MeldrumJon/Paper-Clock/README.md

# Paper-Clock

Minimalistic clock with an e-ink display.

Photo of the ePaper clock

## Components

- [Enclosure](./3D)
- [PCB](./hardware)
- [Firmware](./src)
