MeldrumJon/Paper-Clock/3D/res/rotaryEncoderPCB.stl

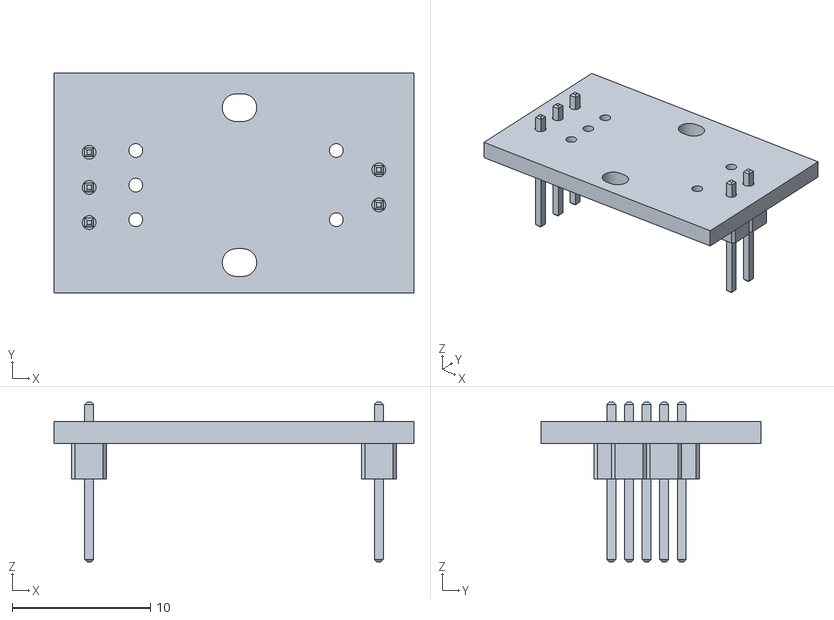
[picture p1: CAD file, 2019-09-21]
3D/res/rotaryEncoderPCB.stl
26.0 x 15.9 x 11.5
