MeldrumJon/Paper-Clock/3D/res/paperClockPCB.stl

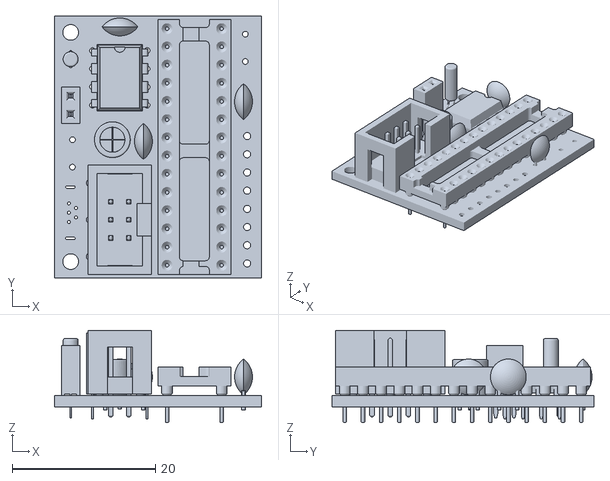
[picture p2: CAD file, 2019-09-15]
3D/res/paperClockPCB.stl
29.0 x 36.6 x 12.9
