MeldrumJon/Paper-Clock/hardware/paperClockPCB.kicad_pcb

## KiCad design hardware/paperClockPCB.kicad_pcb (2019-09-11)

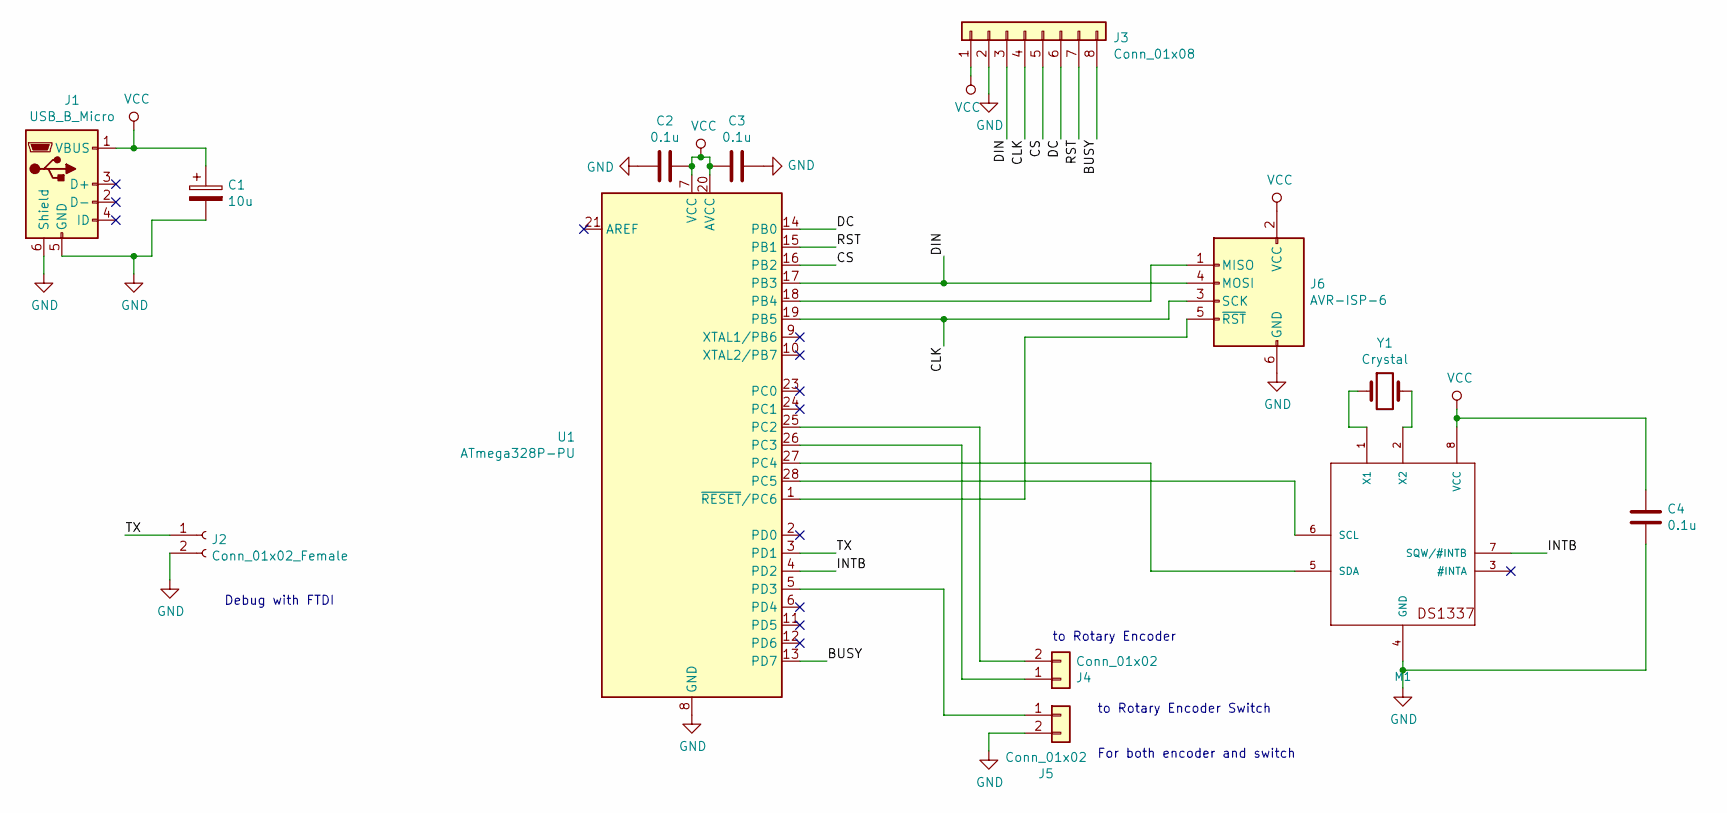
[picture p3: schematic paperClockPCB.sch]

Parts:
C1: 10u; CP_Radial_D5.0mm_P2.00mm
C2, C3, C4: 0.1u; C_Disc_D5.0mm_W2.5mm_P2.50mm
J1: USB_B_Micro; USB_Micro-B_Wuerth_614105150721_Vertical
J2: Conn_01x02_Female; PinSocket_1x02_P2.54mm_Vertical
J3: Conn_01x08; PinSocket_1x08_P2.54mm_Vertical
J4, J5: Conn_01x02; SolderWirePad_1x02_P3.81mm_Drill0.8mm
J6: AVR-ISP-6; IDC-Header_2x03_P2.54mm_Vertical
M1: DS1337; DIP-8_W7.62mm
U1: ATmega328P-PU; DIP-28_W7.62mm_Socket_LongPads
Y1: Crystal; Crystal_C26-LF_D2.1mm_L6.5mm_Vertical

Connections:
/BUSY: J3.8, U1.13 (PD7)
/CLK: J3.4, J6.3 (SCK), U1.19 (PB5)
/CS: J3.5, U1.16 (PB2)
/DC: J3.6, U1.14 (PB0)
/DIN: J3.3, J6.4 (MOSI), U1.17 (PB3)
/INTB: M1.7 (SQW/#INTB), U1.4 (PD2)
/RST: J3.7, U1.15 (PB1)
/TX: J2.1, U1.3 (PD1)
GND: C1.2, C2.2, C3.1, C4.2, J1.5 (GND), J1.6 (Shield), J2.2, J3.2, J5.2, J6.6 (GND), M1.4 (GND), U1.8 (GND), U1.22 (GND)
unnamed: J4.1, U1.26 (PC3)
unnamed: J4.2, U1.25 (PC2)
unnamed: J5.1, U1.5 (PD3)
unnamed: J6.1 (MISO), U1.18 (PB4)
unnamed: J6.5 (~RST), U1.1 (~RESET~/PC6)
unnamed: M1.1 (X1), Y1.1
unnamed: M1.2 (X2), Y1.2
unnamed: M1.5 (SDA), U1.27 (PC4)
unnamed: M1.6 (SCL), U1.28 (PC5)
VCC: C1.1, C2.1, C3.2, C4.1, J1.1 (VBUS), J3.1, J6.2 (VCC), M1.8 (VCC), U1.7 (VCC), U1.20 (AVCC)

Notes on the sheet:
to Rotary Encoder Switch
For both encoder and switch
Debug with FTDI
to Rotary Encoder

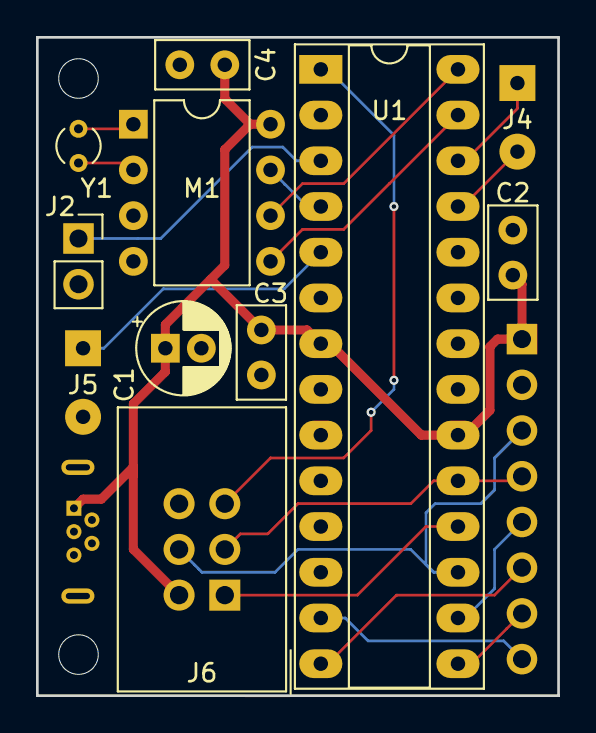
[picture p4: board paperClockPCB.kicad_pcb from above]

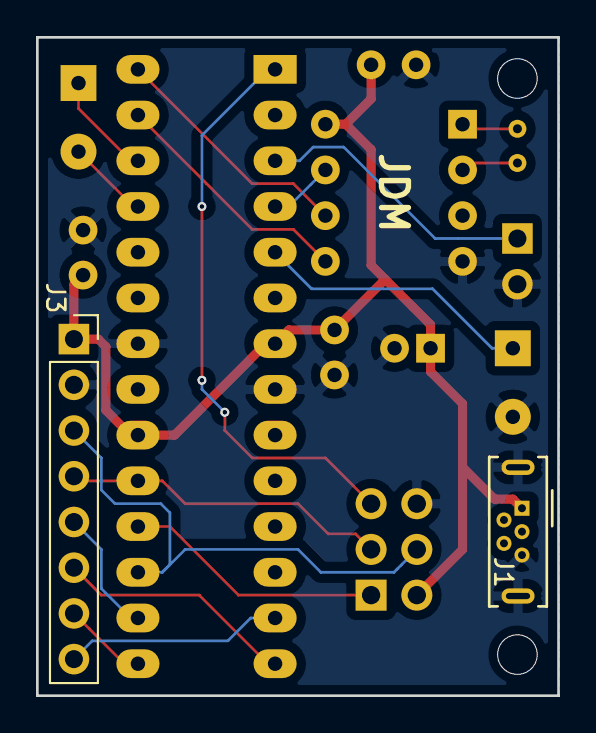
[picture p5: board paperClockPCB.kicad_pcb from below]

Board: 2 copper layers, 29.0 x 36.6 mm, 13 parts (2 on the bottom side), 19 nets.
