MeldrumJon/Paper-Clock/src/src/disp.cpp

#include "disp.h"
#include <avr/pgmspace.h>
#define DISABLE_DIAGNOSTIC_OUTPUT
#define ENABLE_GxEPD2_GFX 0
#include <GxEPD2_BW.h>
#include <U8g2_for_Adafruit_GFX.h>
#include <TimeLib.h>
#include "clock.h"
#include "op.h"

// Fonts
U8G2_FOR_ADAFRUIT_GFX u8g2Fonts;
extern const uint8_t u8g2_font_droidserif_108pt[] U8G2_FONT_SECTION("u8g2_font_droidserif_108pt");
extern const uint8_t u8g2_font_timR18_cc[] U8G2_FONT_SECTION("u8g2_font_timR18_cc");

#define DISP_WIDTH 296
#define DISP_HEIGHT 128

#define SMALL_FONT u8g2_font_timR18_cc
#define BIG_FONT u8g2_font_droidserif_108pt

#define SMALL_FONT_ASCENT 17
#define SMALL_FONT_DESCENT 6
#define SMALL_FONT_HEIGHT 23
#define BIG_FONT_ASCENT 77
#define BIG_FONT_DESCENT 26
#define BIG_FONT_HEIGHT 103

// Fonts
#define TIME_MAX_WIDTH 270

// Main Display

#define DISP_PADDING_TOP 8
#define DISP_PADDING_BOT 12

#define DATE_CURSOR_Y (DISP_PADDING_TOP+SMALL_FONT_ASCENT)
#define TIME_CURSOR_Y (DISP_HEIGHT-DISP_PADDING_BOT)

#define TIME_AREA_PADDING 4

#define TIME_AREA_X ((DISP_WIDTH-TIME_MAX_WIDTH)/2-TIME_AREA_PADDING)
#define TIME_AREA_WIDTH (TIME_MAX_WIDTH+2*TIME_AREA_PADDING)
#define TIME_AREA_Y (DATE_CURSOR_Y+SMALL_FONT_DESCENT+2)
#define TIME_AREA_HEIGHT (DISP_HEIGHT-TIME_AREA_Y)

#define PM_INDICATOR_WIDTH 14
#define PM_INDICATOR_HEIGHT 14
#define PM_INDICATOR_X (DISP_WIDTH-PM_INDICATOR_WIDTH)
#define PM_INDICATOR_Y (DISP_HEIGHT-PM_INDICATOR_HEIGHT)

// Settings
#define SMALL_DATE_WIDTH 45
#define SMALL_TIME_WIDTH 52

#define SET_LINE_SPACING 20

// title
#define SET_TITLE_CURSOR_Y (SET_CURSOR_Y-SET_LINE_SPACING-SMALL_FONT_ASCENT)
#define SET_DATE_TITLE_CURSOR_X ((DISP_WIDTH-SMALL_DATE_WIDTH)/2)
#define SET_TIME_TITLE_CURSOR_X ((DISP_WIDTH-SMALL_TIME_WIDTH)/2)

// "set"
#define SET_SAVE_CURSOR_Y (SET_CURSOR_Y+SET_LINE_SPACING+SMALL_FONT_ASCENT)
#define SET_SAVE_AREA_Y (SET_SAVE_CURSOR_Y-SMALL_FONT_ASCENT-1)
#define SET_SAVE_AREA_HEIGHT (SMALL_FONT_ASCENT+2)

#define SET_SAVE_WIDTH 31
#define SET_SAVING_WIDTH 16
#define SET_SAVE_CURSOR_X ((DISP_WIDTH-SET_SAVE_WIDTH)/2)
#define SET_SAVING_CURSOR_X ((DISP_WIDTH-SET_SAVING_WIDTH)/2)

// actual settings
#define SET_CURSOR_Y ((DISP_HEIGHT+SMALL_FONT_ASCENT)/2)
#define SET_AREA_Y ((DISP_HEIGHT-SMALL_FONT_ASCENT)/2-1)
#define SET_AREA_HEIGHT (SMALL_FONT_ASCENT+2)

// date or time
#define SET_DOT_SPACING 56
#define SET_DOT_WIDTH (SMALL_DATE_WIDTH+SET_DOT_SPACING+SMALL_TIME_WIDTH)

#define SET_DOT_DATE_CURSOR_X ((DISP_WIDTH-SET_DOT_WIDTH)/2)
#define SET_DOT_TIME_CURSOR_X (SET_DOT_DATE_CURSOR_X+SMALL_DATE_WIDTH+SET_DOT_SPACING)

// date
#define SMALL_DASH_WIDTH 6
#define SMALL_YEAR_WIDTH 47
#define SMALL_MONTH_WIDTH 23
#define SMALL_DAY_WIDTH 23

#define SET_DATE_SPACING 16
#define SET_DATE_WIDTH (SMALL_YEAR_WIDTH+SMALL_MONTH_WIDTH+SMALL_DAY_WIDTH+2*SMALL_DASH_WIDTH+4*SET_DATE_SPACING)
#define SET_DATE_CURSOR_X ((DISP_WIDTH-SET_DATE_WIDTH)/2)

#define SET_DATE_YEAR_CURSOR_X (SET_DATE_CURSOR_X)
#define SET_DATE_DASH1_CURSOR_X (SET_DATE_YEAR_CURSOR_X+SMALL_YEAR_WIDTH+SET_DATE_SPACING)
#define SET_DATE_MONTH_CURSOR_X (SET_DATE_DASH1_CURSOR_X+SMALL_DASH_WIDTH+SET_DATE_SPACING)
#define SET_DATE_DASH2_CURSOR_X (SET_DATE_MONTH_CURSOR_X+SMALL_MONTH_WIDTH+SET_DATE_SPACING)
#define SET_DATE_DAY_CURSOR_X (SET_DATE_DASH2_CURSOR_X+SMALL_DASH_WIDTH+SET_DATE_SPACING)

// time
#define SMALL_MERIDIEM_WIDTH 39
#define SMALL_HOUR_WIDTH 23
#define SMALL_COLON_WIDTH 4
#define SMALL_MINUTE_WIDTH 23

#define SET_TIME_MERIDIEM_SPACING 34
#define SET_TIME_COLON_SPACING 12

#define SET_TIME_WIDTH (SMALL_MERIDIEM_WIDTH+SMALL_HOUR_WIDTH+SMALL_MINUTE_WIDTH+SMALL_COLON_WIDTH+SET_TIME_MERIDIEM_SPACING+2*SET_TIME_COLON_SPACING)
#define SET_TIME_CURSOR_X ((DISP_WIDTH-SET_TIME_WIDTH)/2)

#define SET_TIME_MERIDIEM_CURSOR_X SET_TIME_CURSOR_X
#define SET_TIME_HOUR_CURSOR_X (SET_TIME_MERIDIEM_CURSOR_X+SMALL_MERIDIEM_WIDTH+SET_TIME_MERIDIEM_SPACING)
#define SET_TIME_COLON_CURSOR_X (SET_TIME_HOUR_CURSOR_X+SMALL_HOUR_WIDTH+SET_TIME_COLON_SPACING)
#define SET_TIME_MINUTE_CURSOR_X (SET_TIME_COLON_CURSOR_X+SMALL_COLON_WIDTH+SET_TIME_COLON_SPACING)

// Display
#define MAX_DISPAY_BUFFER_SIZE 800 
#define MAX_HEIGHT(EPD) (EPD::HEIGHT <= MAX_DISPAY_BUFFER_SIZE / (EPD::WIDTH / 8) ? EPD::HEIGHT : MAX_DISPAY_BUFFER_SIZE / (EPD::WIDTH / 8))
GxEPD2_BW<GxEPD2_290, MAX_HEIGHT(GxEPD2_290)> display(GxEPD2_290(/*CS=10*/ SS, /*DC=*/ 8, /*RST=*/ 9, /*BUSY=*/ 7));


// Strings
static const char MIL_STR[] = " 24";
static const char AM_STR[] = "AM";
static const char PM_STR[] = "PM";
static const char* const MERIDIEM_STR[3] = {
    MIL_STR,
    AM_STR,
    PM_STR
};
static const char DATE_STR[] = "Date";
static const char TIME_STR[] = "Time";
static const char SAVE_STR[] = "Set";
static const char SAVING_STR[] = "...";

// Variables

// Date/Time Buffers
static char buf18[24]; // Longest date string: "Wednesday, Sep 20, 2019" = 23 chars + \0
static char buf6[6]; // Longest time "12:00" = 5 chars + \0
static char buf3[3]; // Additional settings (days, months, hours, minutes)

static enum updateMode_t {
    FULL,
    TIME
} updateMode;

void disp_init() {
    display.init();
    display.setRotation(1);
    u8g2Fonts.begin(display);
    return;
}

void disp_clear() {
    display.setFullWindow();
    display.firstPage();
    do {
        display.fillScreen(GxEPD_WHITE);
    } while(display.nextPage());
    return;
}

void disp_update(uint8_t refresh /*=0*/) {
    static uint16_t last_year = 0;
    static uint8_t last_month = 0;
    static uint8_t last_day = 0;
    static uint8_t last_hour = 0;
    static uint8_t last_minute = 0;
    static op_meridiem_t last_meridiem = MIL;

    static uint16_t date_x;
    static uint16_t time_x;

    uint8_t date_diff = (op_day != last_day || op_month != last_month || op_year != last_year);
    uint8_t time_diff = (op_minute != last_minute || op_hour != last_hour || op_meridiem != last_meridiem);

    if (!time_diff && !date_diff && !refresh) { // No change, don't do anything
        return;
    }

    if (date_diff || refresh) {
        // Update Date
        sprintf(buf18, "%s, %s %d, %d", 
                dayStr(clock_dayofweek(op_year, op_month, op_day)),
                monthShortStr(op_month), op_day, op_year);
        u8g2Fonts.setFont(SMALL_FONT);
        date_x = (DISP_WIDTH-u8g2Fonts.getUTF8Width(buf18))/2;
    }

    // Update Time
    if (op_meridiem != MIL) {
        sprintf(buf6, "%d:%02d", op_hour, op_minute);
    }
    else {
        sprintf(buf6, "%02d:%02d", op_hour, op_minute);
    }
    u8g2Fonts.setFont(BIG_FONT);
    time_x = (DISP_WIDTH-u8g2Fonts.getUTF8Width(buf6))/2; // Center
    if (op_hour >= 10 && op_hour < 20) { time_x -= 3; }

    u8g2Fonts.setForegroundColor(GxEPD_BLACK);
    u8g2Fonts.setBackgroundColor(GxEPD_WHITE);
    if ((op_minute % 30) == 0 || date_diff || refresh) {
        display.setFullWindow();
        display.firstPage();
        do {
            display.fillScreen(GxEPD_WHITE);
            if (op_meridiem == PM) { 
                display.writeFillRect(PM_INDICATOR_X, PM_INDICATOR_Y, PM_INDICATOR_WIDTH, PM_INDICATOR_HEIGHT, GxEPD_BLACK);
            }
            u8g2Fonts.setFont(SMALL_FONT);
            u8g2Fonts.setCursor(date_x, DATE_CURSOR_Y);
            u8g2Fonts.print(buf18);
            u8g2Fonts.setFont(BIG_FONT);
            u8g2Fonts.setCursor(time_x, TIME_CURSOR_Y);
            u8g2Fonts.print(buf6);
        } while (display.nextPage());
    }
    else {
        display.setPartialWindow(TIME_AREA_X, TIME_AREA_Y,
                TIME_AREA_WIDTH, TIME_AREA_HEIGHT);
        u8g2Fonts.setFont(BIG_FONT);
        display.firstPage();
        do {
            display.fillScreen(GxEPD_WHITE);
            if (op_meridiem == PM) { 
                display.writeFillRect(PM_INDICATOR_X, PM_INDICATOR_Y, PM_INDICATOR_WIDTH, PM_INDICATOR_HEIGHT, GxEPD_BLACK);
            }
            u8g2Fonts.setCursor(time_x, TIME_CURSOR_Y);
            u8g2Fonts.print(buf6);
        } while (display.nextPage());
    }
    display.hibernate();

    last_year = op_year;
    last_month = op_month;
    last_day = op_day;
    last_hour = op_hour;
    last_minute = op_minute;
    last_meridiem = op_meridiem;
    return;
}

void disp_setDoT(uint8_t dateTime_n) {
    uint16_t date_fg;
    uint16_t date_bg;
    uint16_t time_fg;
    uint16_t time_bg;
    uint16_t rect_x;
    uint16_t rect_w;
    if (dateTime_n) {
        date_fg = GxEPD_WHITE;
        date_bg = GxEPD_BLACK;
        time_fg = GxEPD_BLACK;
        time_bg = GxEPD_WHITE;
        rect_x  = SET_DOT_DATE_CURSOR_X-1;
        rect_w  = SMALL_DATE_WIDTH+2;
    }
    else {
        date_fg = GxEPD_BLACK;
        date_bg = GxEPD_WHITE;
        time_fg = GxEPD_WHITE;
        time_bg = GxEPD_BLACK;
        rect_x  = SET_DOT_TIME_CURSOR_X-1;
        rect_w  = SMALL_TIME_WIDTH+2;
    }

    display.setPartialWindow(SET_DOT_DATE_CURSOR_X-1, SET_AREA_Y,
            SET_DOT_WIDTH+2, SET_AREA_HEIGHT);
    
    u8g2Fonts.setFont(SMALL_FONT);
    display.firstPage();
    do {
            display.fillScreen(GxEPD_WHITE);

            display.writeFillRect(rect_x, SET_AREA_Y,
                    rect_w, SET_AREA_HEIGHT,
                    GxEPD_BLACK);
            
            u8g2Fonts.setForegroundColor(date_fg);
            u8g2Fonts.setBackgroundColor(date_bg);
            u8g2Fonts.setCursor(SET_DOT_DATE_CURSOR_X, SET_CURSOR_Y);
            u8g2Fonts.print(DATE_STR); 

            u8g2Fonts.setForegroundColor(time_fg);
            u8g2Fonts.setBackgroundColor(time_bg);
            u8g2Fonts.setCursor(SET_DOT_TIME_CURSOR_X, SET_CURSOR_Y);
            u8g2Fonts.print(TIME_STR); 
    } while (display.nextPage());
    
    return;
}

void disp_setTime(op_meridiem_t meridiem, int8_t h, int8_t m) {
    char* meridiem_str = (char*) MERIDIEM_STR[(int)meridiem];
    sprintf(buf6, "%02d", h);
    sprintf(buf3, "%02d", m);

    display.setFullWindow();

    u8g2Fonts.setFont(SMALL_FONT);
    u8g2Fonts.setForegroundColor(GxEPD_BLACK);
    u8g2Fonts.setBackgroundColor(GxEPD_WHITE);
    display.firstPage();
    do {
        display.fillScreen(GxEPD_WHITE);

        u8g2Fonts.setCursor(SET_TIME_TITLE_CURSOR_X, SET_TITLE_CURSOR_Y);
        u8g2Fonts.print(TIME_STR);

        u8g2Fonts.setCursor(SET_TIME_MERIDIEM_CURSOR_X, SET_CURSOR_Y);
        u8g2Fonts.print(meridiem_str); 

        u8g2Fonts.setCursor(SET_TIME_HOUR_CURSOR_X, SET_CURSOR_Y);
        u8g2Fonts.print(buf6); 

        u8g2Fonts.setCursor(SET_TIME_COLON_CURSOR_X, SET_CURSOR_Y);
        u8g2Fonts.print(':'); 

        u8g2Fonts.setCursor(SET_TIME_MINUTE_CURSOR_X, SET_CURSOR_Y);
        u8g2Fonts.print(buf3); 
    } while(display.nextPage());

    return;
}

void disp_setDate(uint16_t yr, int8_t m, int8_t d) {
    sprintf(buf18, "%04d", yr);
    sprintf(buf6, "%02d", m);
    sprintf(buf3, "%02d", d);

    display.setFullWindow();

    u8g2Fonts.setFont(SMALL_FONT);
    u8g2Fonts.setForegroundColor(GxEPD_BLACK);
    u8g2Fonts.setBackgroundColor(GxEPD_WHITE);
    display.firstPage();
    do {
        display.fillScreen(GxEPD_WHITE);

        u8g2Fonts.setCursor(SET_DATE_TITLE_CURSOR_X, SET_TITLE_CURSOR_Y);
        u8g2Fonts.print(DATE_STR);

        u8g2Fonts.setCursor(SET_DATE_YEAR_CURSOR_X, SET_CURSOR_Y);
        u8g2Fonts.print(buf18); 

        u8g2Fonts.setCursor(SET_DATE_DASH1_CURSOR_X, SET_CURSOR_Y);
        u8g2Fonts.print('-'); 

        u8g2Fonts.setCursor(SET_DATE_MONTH_CURSOR_X, SET_CURSOR_Y);
        u8g2Fonts.print(buf6); 

        u8g2Fonts.setCursor(SET_DATE_DASH2_CURSOR_X, SET_CURSOR_Y);
        u8g2Fonts.print('-'); 

        u8g2Fonts.setCursor(SET_DATE_DAY_CURSOR_X, SET_CURSOR_Y);
        u8g2Fonts.print(buf3); 
    } while(display.nextPage());

    return;
}

static void _setSetting(char* str, uint8_t sel, uint16_t cursor_x, uint16_t str_width) {
    uint16_t bg = sel ? GxEPD_BLACK : GxEPD_WHITE;
    uint16_t fg = sel ? GxEPD_WHITE : GxEPD_BLACK;
    
    display.setPartialWindow(cursor_x-1, SET_AREA_Y, str_width+2, SET_AREA_HEIGHT);

    u8g2Fonts.setFont(SMALL_FONT);
    u8g2Fonts.setForegroundColor(fg);
    u8g2Fonts.setBackgroundColor(bg);
    display.firstPage();
    do {
        display.fillScreen(bg);

        u8g2Fonts.setCursor(cursor_x, SET_CURSOR_Y);
        u8g2Fonts.print(str); 
    } while(display.nextPage());

    return;
}

void disp_setTimeMeridiem(op_meridiem_t meridiem, uint8_t sel) {
    char* meridiem_str = (char*) MERIDIEM_STR[(int)meridiem];
    _setSetting(meridiem_str, sel, SET_TIME_MERIDIEM_CURSOR_X, SMALL_MERIDIEM_WIDTH);
    return;
}

void disp_setTimeHour(int8_t h, uint8_t sel) {
    sprintf(buf6, "%02d", h);
    _setSetting(buf6, sel, SET_TIME_HOUR_CURSOR_X, SMALL_HOUR_WIDTH);
    return;
}

void disp_setTimeMinute(int8_t m, uint8_t sel) {
    sprintf(buf3, "%02d", m);
    _setSetting(buf3, sel, SET_TIME_MINUTE_CURSOR_X, SMALL_DAY_WIDTH);
    return;
}


void disp_setDateYear(uint16_t yr, uint8_t sel) {
    sprintf(buf18, "%04d", yr);
    _setSetting(buf18, sel, SET_DATE_YEAR_CURSOR_X, SMALL_YEAR_WIDTH);
    return;
}

void disp_setDateMonth(int8_t m, uint8_t sel) {
    sprintf(buf6, "%02d", m);
    _setSetting(buf6, sel, SET_DATE_MONTH_CURSOR_X, SMALL_MONTH_WIDTH);
    return;
}

void disp_setDateDay(int8_t d, uint8_t sel) {
    sprintf(buf3, "%02d", d);
    _setSetting(buf3, sel, SET_DATE_DAY_CURSOR_X, SMALL_DAY_WIDTH);
    return;
}

void disp_setSave() {
    display.setPartialWindow(SET_SAVE_CURSOR_X-1, SET_SAVE_AREA_Y,
            SET_SAVE_WIDTH+2, SET_SAVE_AREA_HEIGHT);

    u8g2Fonts.setFont(SMALL_FONT);
    u8g2Fonts.setForegroundColor(GxEPD_WHITE);
    u8g2Fonts.setBackgroundColor(GxEPD_BLACK);
    display.firstPage();
    do {
        display.fillScreen(GxEPD_BLACK);
        u8g2Fonts.setCursor(SET_SAVE_CURSOR_X, SET_SAVE_CURSOR_Y);
        u8g2Fonts.print(SAVE_STR);
    } while (display.nextPage());
}

void disp_setSaving() {
    // Use SAVE_WIDTH instead of SAVING_WIDTH, since "Set" is wider than "..."
    display.setPartialWindow(SET_SAVE_CURSOR_X-1, SET_SAVE_AREA_Y,
            SET_SAVE_WIDTH+2, SET_SAVE_AREA_HEIGHT);

    u8g2Fonts.setFont(SMALL_FONT);
    u8g2Fonts.setForegroundColor(GxEPD_BLACK);
    u8g2Fonts.setBackgroundColor(GxEPD_WHITE);
    display.firstPage();
    do {
        display.fillScreen(GxEPD_WHITE);
        u8g2Fonts.setCursor(SET_SAVING_CURSOR_X, SET_SAVE_CURSOR_Y);
        u8g2Fonts.print(SAVING_STR);
    } while (display.nextPage());
}
