MeldrumJon/Paper-Clock/src/src/btn.cpp

#include "btn.h"
#include <stdint.h>
#include <avr/interrupt.h>
#include <avr/io.h>
#include "timer.h"

#define DEBOUNCE_TICKS TIMER_TICKS(50)
#define LONGPRESS_TICKS TIMER_TICKS(3000)

static enum btn_st_t {
	LOW_ST,
	WAIT_ST,
	HIGH_ST,
	LONG_ST
} currentState = LOW_ST;

uint8_t btn_press_flag = 0;
uint8_t btn_longpress_flag = 0;

volatile uint_fast8_t btn_intrpt_flag = 0;

#define BTN_DMASK 0x08
#define INT1_EN_MASK 0x02

ISR(INT1_vect, ISR_BLOCK) {
	btn_intrpt_flag = !(0); // Do something with this flag to turn back on timer2
}

void btn_enable(void) {
	sei();
	DDRD &= ~(BTN_DMASK); // Set pin as input
	PORTD |= BTN_DMASK; // Activate pull-up
	EICRA |= 0x08; // Falling edge interrupt
	EIMSK |= INT1_EN_MASK; // Set interrupt mask on INT1
	cli();
	return;
}

void btn_disable(void) {
	sei();
	DDRD |= BTN_DMASK; // Set pin as out
	PORTD &= ~(BTN_DMASK); // Drive low
	EIMSK &= ~(INT1_EN_MASK); // Disable interrupt
	cli();
	return;
}

void btn_tick(void) {
    static uint16_t counter;
	uint8_t btn = !(PIND & BTN_DMASK); // Get button state (active-low)

	// State action
	switch (currentState) {
		case LOW_ST:
			break;
		case WAIT_ST:
			++counter;
			break;
		case HIGH_ST:
			++counter;
			btn_press_flag = 0;
			break;
		case LONG_ST:
			btn_longpress_flag = 0;
			break;
		default:
			break;
	}
	
	// State transition
	switch (currentState) {
		case LOW_ST:
			if (btn) {
				counter = 0;
				currentState = WAIT_ST;
			}
			break;
		case WAIT_ST:
			if (!btn) {
				currentState = LOW_ST;
			}
			else if (counter >= DEBOUNCE_TICKS) {
				counter = 0;
				btn_press_flag = !(0);
				currentState = HIGH_ST;
			}
			break;
		case HIGH_ST:
			if (!btn) {
				currentState = LOW_ST;
			}
			else if (counter >= LONGPRESS_TICKS) {
				btn_longpress_flag = !(0);
				currentState = LONG_ST;
			}
			break;
		case LONG_ST:
			if (!btn) {
				currentState = LOW_ST;
			}
			break;
		default:
			break;
	}
	
	return;
}
