MeldrumJon/Paper-Clock/(commit log)

2019-08-17 Arduino U8G2
    (switching to standalone C)
2019-08-17 Revert "Arduino U8G2"
    This reverts commit fea71a2b21564d61849765bd730da9470b42badc.
    [prgm.cpp]
2019-08-18 Switch Libraries, Partial Update Working
2019-08-19 Almost ready to print
    Must figure out why it doesn't call disp_time();
    [clock.cpp, clock.h, disp.cpp, disp.h, prgm.cpp, usart.h]
2019-08-21 Display Works, Switch to GxEPD2
2019-09-04 Encoder and button working.
2019-09-11 PCB project
    [paperClockPCB.kicad_pcb, paperClockPCB.sch]
2019-09-11 PCB v0.1
    [paperClockPCB.kicad_pcb, paperClockPCB.sch]
2019-09-11 Include 3rd Party Libraries
    [paperClockPCB.kicad_pcb, paperClockPCB.sch]
2019-09-15 Beginning Enclosure
    [Enclosure.scad, paperClockPCB.stl]
2019-09-16 Code Reorganization
    [Enclosure.scad, display.scad, pcb.scad]
2019-09-17 Enclosure with guides
    [Enclosure.scad, display.scad, mylib.scad]
2019-09-17 Outside structure
    [Enclosure.scad, display.scad]
2019-09-21 Nearly Completed Box
    [Enclosure.scad, display.scad, encoder.scad, mylib.scad, pcb.scad, rotaryEncoderPCB.stl]
2019-10-12 Make model smaller, ordered print.
    [Enclosure.scad, mylib.scad]
2019-11-09 Rename PCB Folder
    [paperClockPCB.kicad_pcb, paperClockPCB.sch]
2019-11-09 Update Enclosure README
2019-11-09 Improved Enclosure
    Make Threaded Inserts easier to insert
    [Enclosure.scad, mylib.scad]
2019-11-09 Add Link to Enclosure on Shapeways
2019-11-09 Link to OSHPark PCB
2019-11-10 Power Saving While Screen is Busy
2019-11-10 Update Libraries; Power Saving While Waiting for Screen
